RoshanAnand23/keyboard-PCB-design/Keyboard Overall Layout.jpg

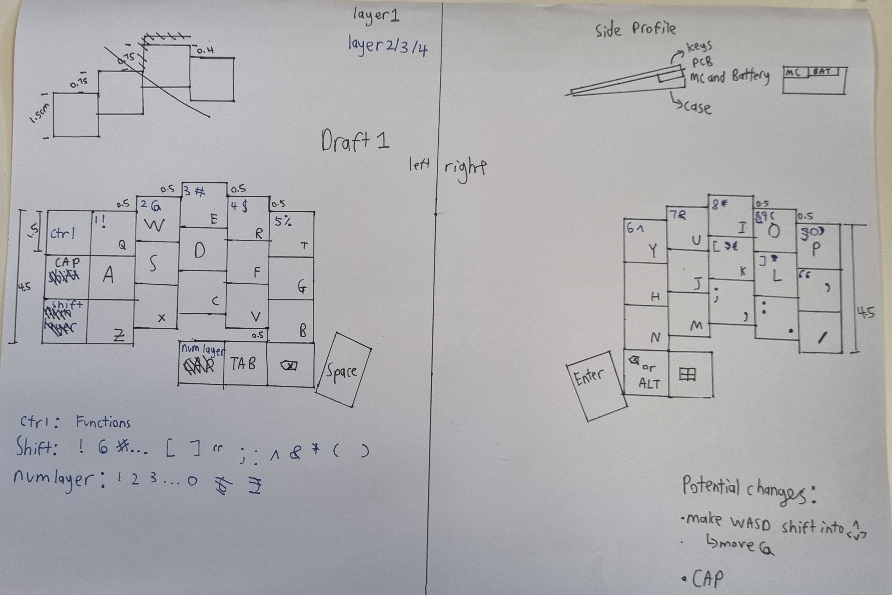
Keyboard Overall Layout.jpg
