RoshanAnand23/keyboard-PCB-design/README.md

# keyboard-PCB-design
learning to design a keyboard from pcb level
