RoshanAnand23/keyboard-PCB-design/Pinout comparison.docx

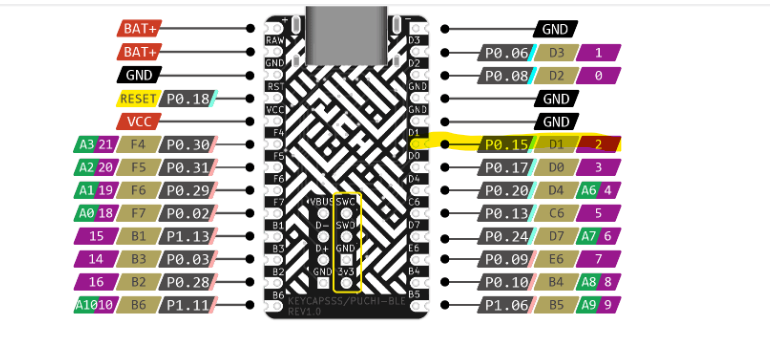
[picture p2: figure]
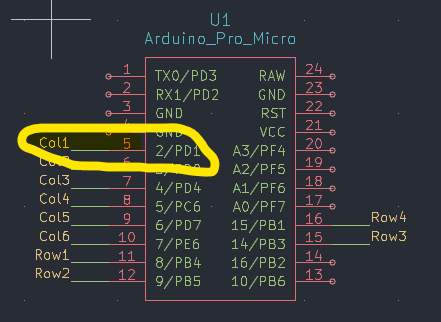
[picture p3: figure]

For future reference of how the schematic and physical pins correlate
