RoshanAnand23/keyboard-PCB-design/LeftKeyboard_kicad/Screenshots/LeftKeyboard-PCBLAYOUT.png

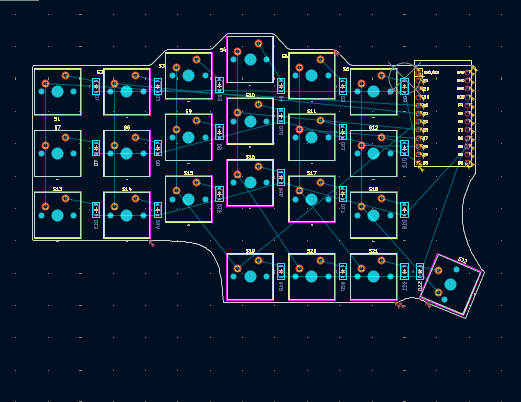
LeftKeyboard_kicad/Screenshots/LeftKeyboard-PCBLAYOUT.png
