RoshanAnand23/keyboard-PCB-design/LeftKeyboard_kicad/Screenshots/LeftKeyboardFinalPCB.png

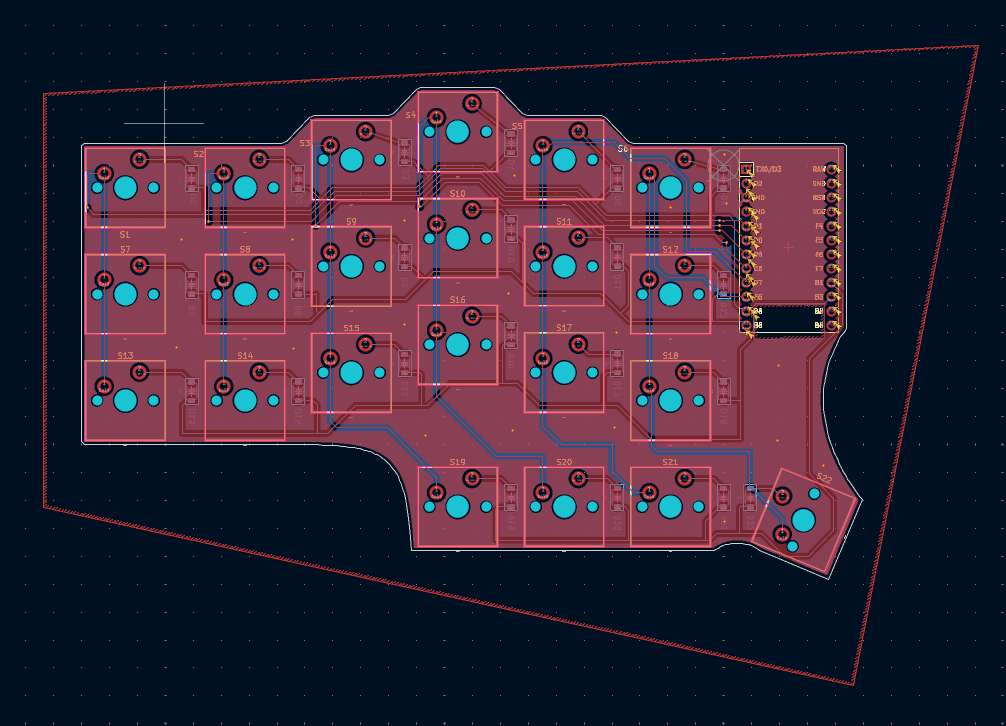
LeftKeyboard_kicad/Screenshots/LeftKeyboardFinalPCB.png
