RoshanAnand23/keyboard-PCB-design/LeftKeyboard_kicad/Screenshots/LeftKeyboardROUTING.png

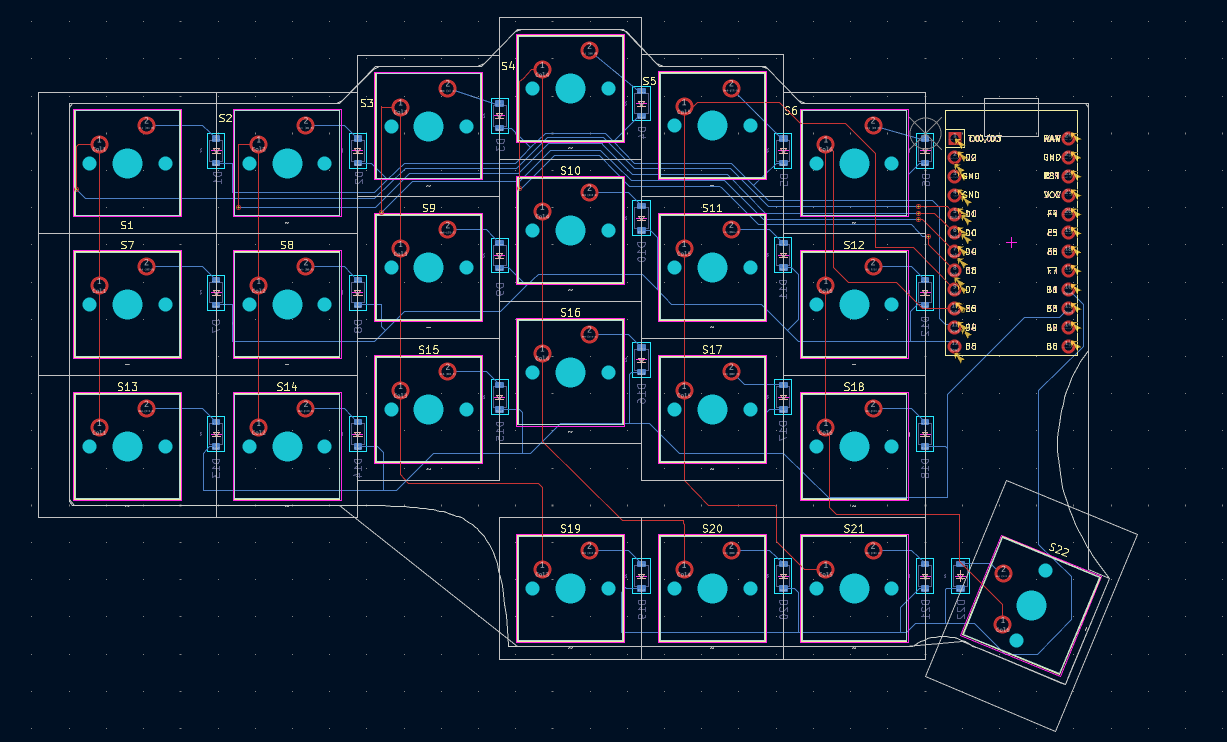
LeftKeyboard_kicad/Screenshots/LeftKeyboardROUTING.png
