RoshanAnand23/keyboard-PCB-design/LeftKeyboard_kicad/Screenshots/LeftKeyboardSchematicImag.png

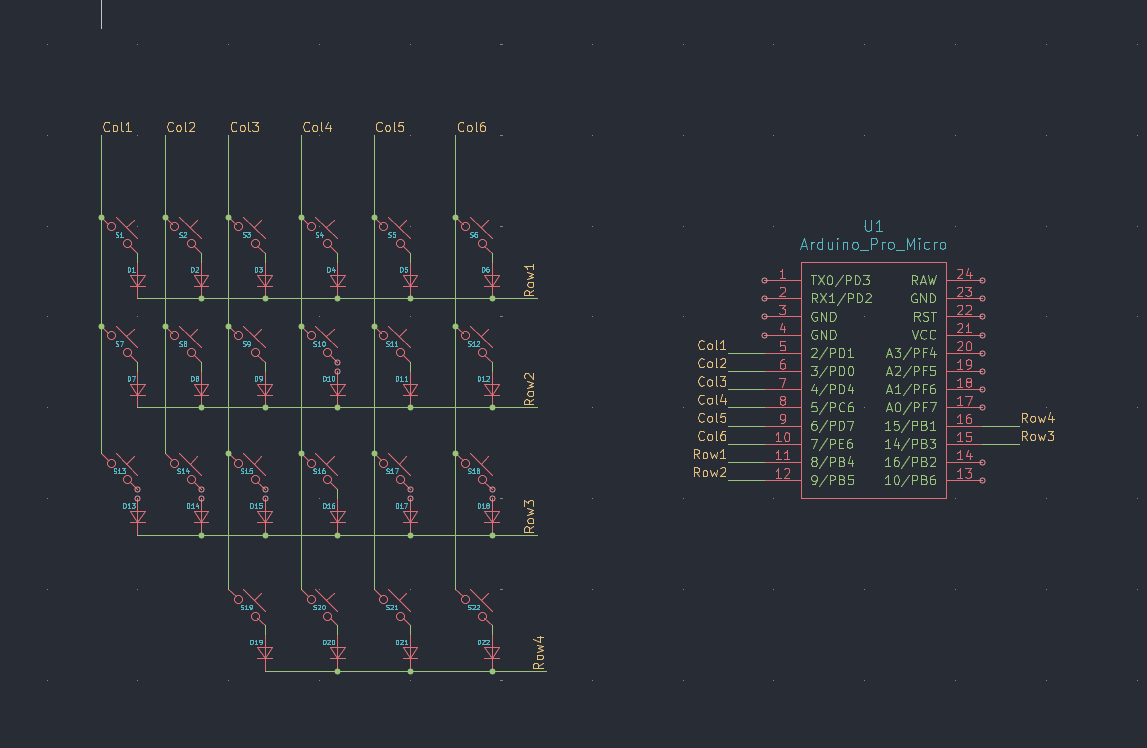
LeftKeyboard_kicad/Screenshots/LeftKeyboardSchematicImag.png
