RoshanAnand23/keyboard-PCB-design/RightKeyboard_kicad/RightKeyboardROUTING.png

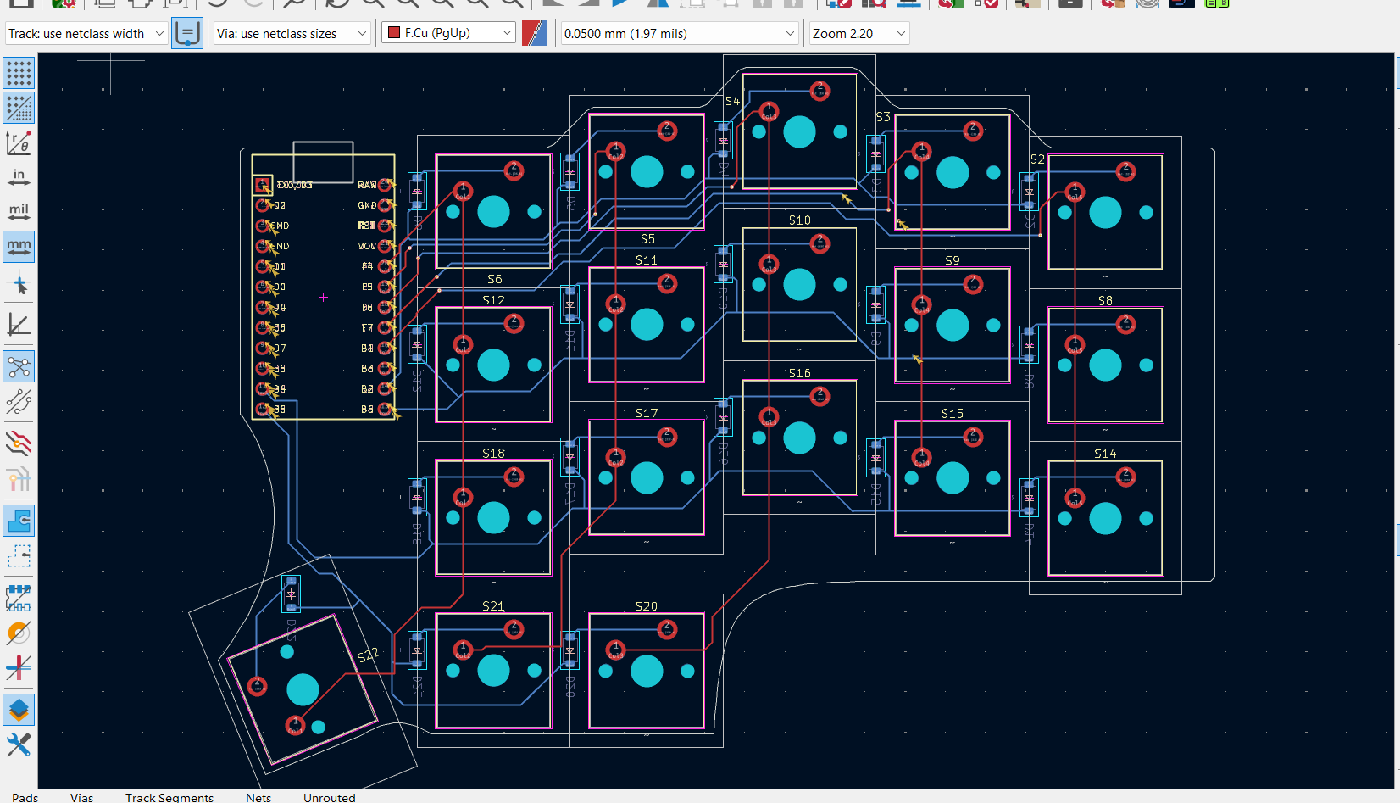
RightKeyboard_kicad/RightKeyboardROUTING.png
