RoshanAnand23/keyboard-PCB-design/RightKeyboard_kicad/Screenshot/RightKeyboardFinalPCB.png

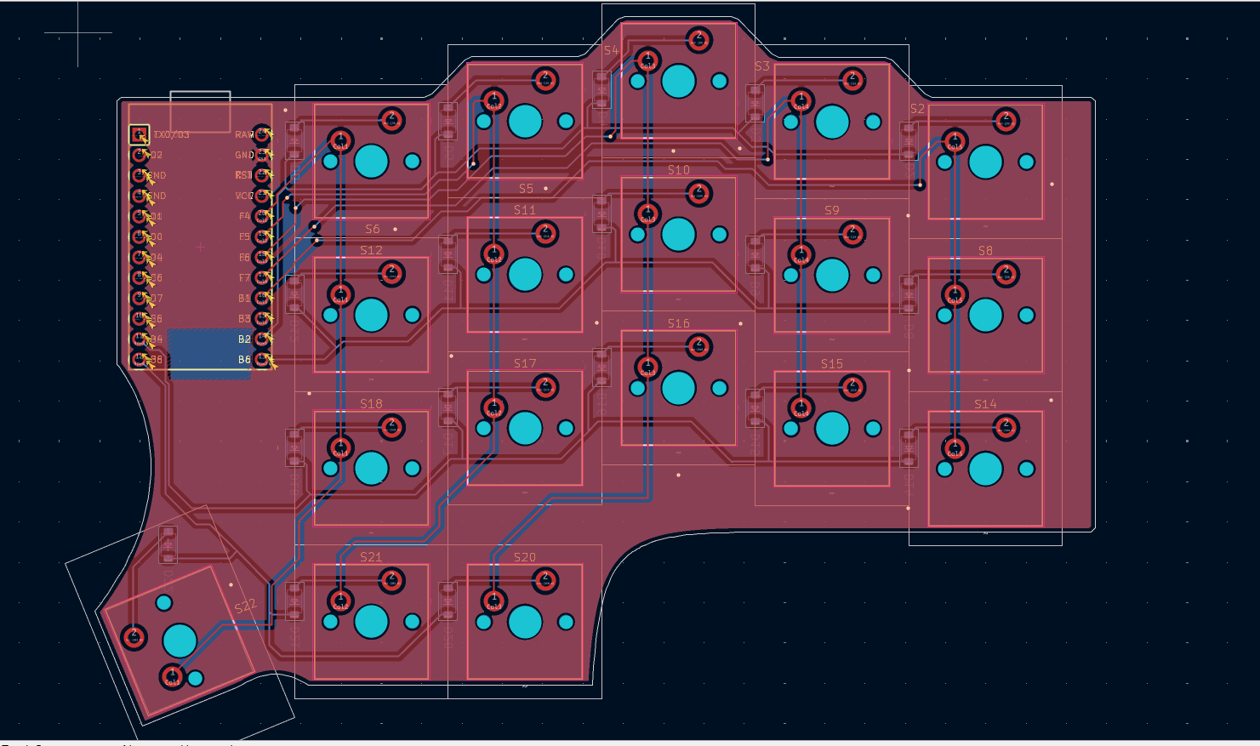
RightKeyboard_kicad/Screenshot/RightKeyboardFinalPCB.png
