RoshanAnand23/keyboard-PCB-design/RightKeyboard_kicad/RightKeyboard_kicad.kicad_pcb

## KiCad design RightKeyboard_kicad/RightKeyboard_kicad.kicad_pcb (2026-08-26)

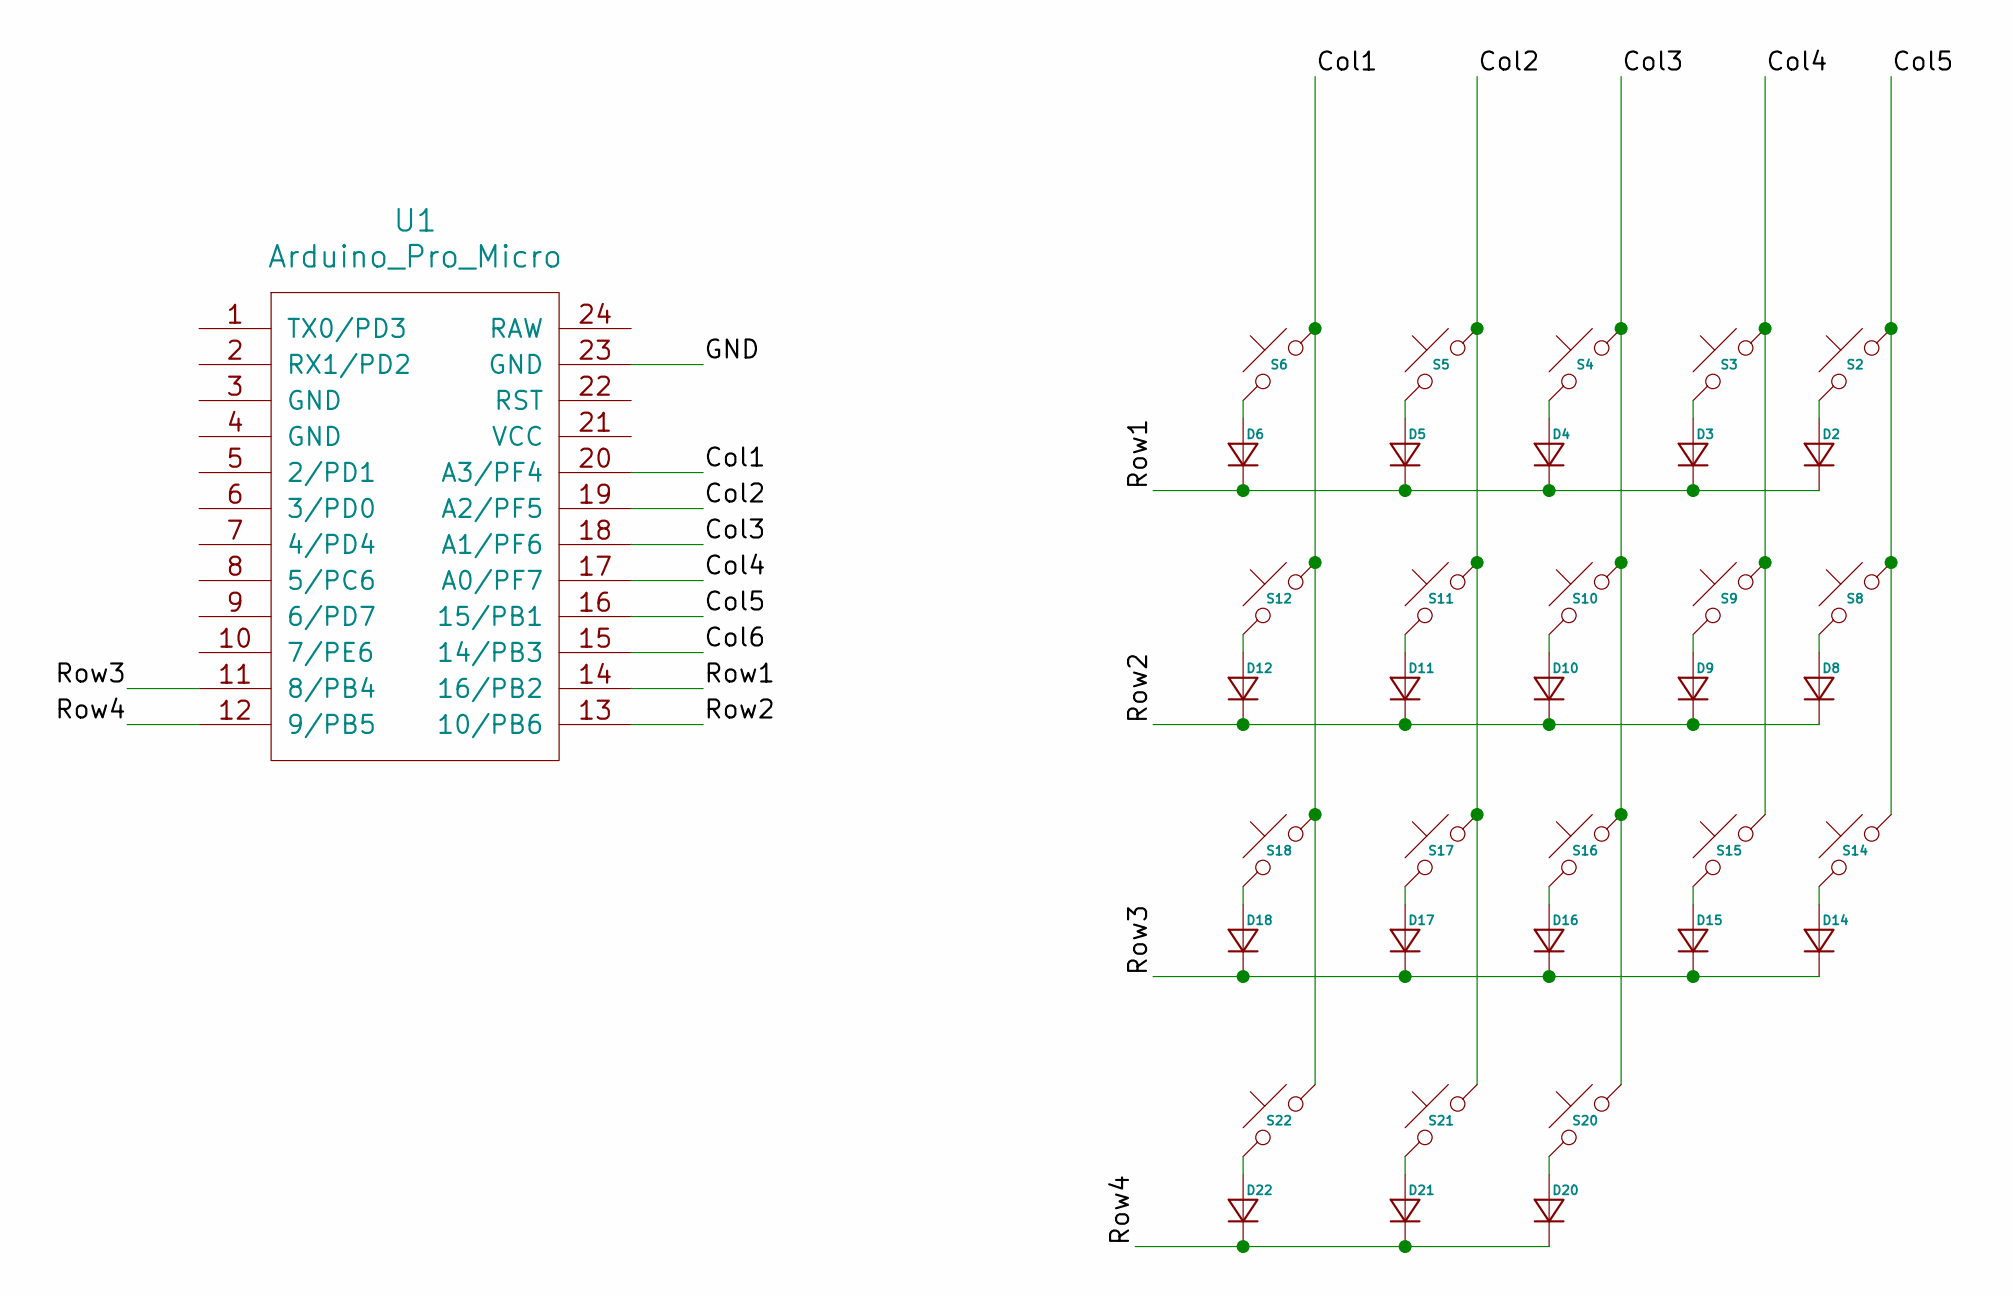
[picture p10: schematic RightKeyboard_kicad.kicad_sch]

Parts:
D2, D3, D4, D5, D6, D8, D9, D10, D11, D12, D14, D15, D16, D17, D18, D20, D21, D22: Diode_SOD-123
S2, S3, S4, S5, S6, S8, S9, S10, S11, S12, S14, S15, S16, S17, S18, S20, S21: MX_PCB_1.00u
S22: MX_PCB_1.50u
U1: Arduino_Pro_Micro

Connections:
/Col1: S6.1, S12.1, S18.1, S22.1, U1.20 (A3/PF4)
/Col2: S5.1, S11.1, S17.1, S21.1, U1.19 (A2/PF5)
/Col3: S4.1, S10.1, S16.1, S20.1, U1.18 (A1/PF6)
/Col4: S3.1, S9.1, S15.1, U1.17 (A0/PF7)
/Col5: S2.1, S8.1, S14.1, U1.16 (15/PB1)
/Col6: U1.15 (14/PB3)
/GND: U1.23 (GND)
/Row1: D2.1 (K), D3.1 (K), D4.1 (K), D5.1 (K), D6.1 (K), U1.14 (16/PB2)
/Row2: D8.1 (K), D9.1 (K), D10.1 (K), D11.1 (K), D12.1 (K), U1.13 (10/PB6)
/Row3: D14.1 (K), D15.1 (K), D16.1 (K), D17.1 (K), D18.1 (K), U1.11 (8/PB4)
/Row4: D20.1 (K), D21.1 (K), D22.1 (K), U1.12 (9/PB5)
unnamed: D2.2 (A), S2.2
unnamed: D3.2 (A), S3.2
unnamed: D4.2 (A), S4.2
unnamed: D5.2 (A), S5.2
unnamed: D6.2 (A), S6.2
unnamed: D8.2 (A), S8.2
unnamed: D9.2 (A), S9.2
unnamed: D10.2 (A), S10.2
unnamed: D11.2 (A), S11.2
unnamed: D12.2 (A), S12.2
unnamed: D14.2 (A), S14.2
unnamed: D15.2 (A), S15.2
unnamed: D16.2 (A), S16.2
unnamed: D17.2 (A), S17.2
unnamed: D18.2 (A), S18.2
unnamed: D20.2 (A), S20.2
unnamed: D21.2 (A), S21.2
unnamed: D22.2 (A), S22.2

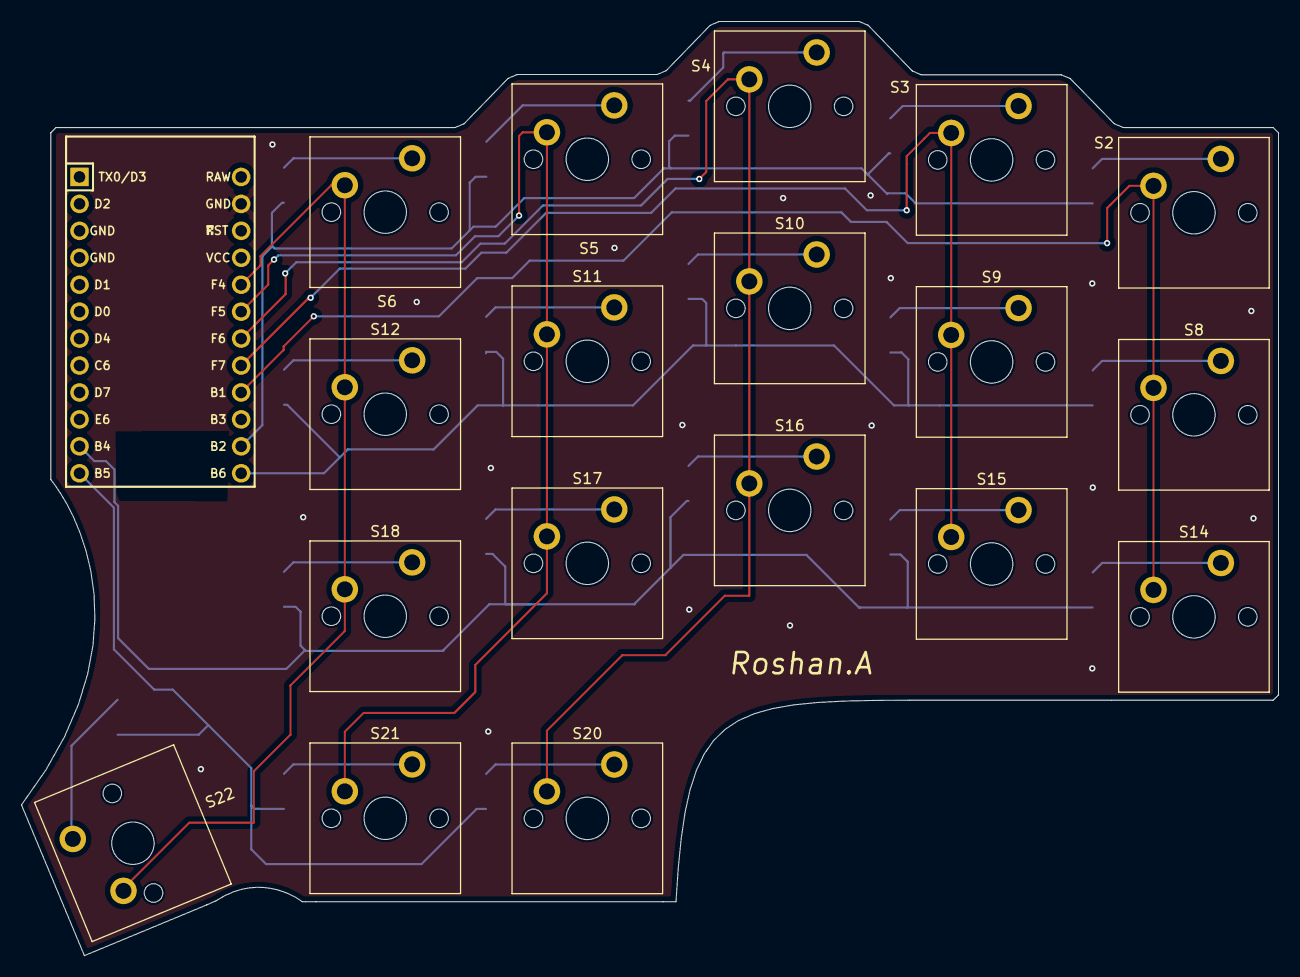
[picture p11: board RightKeyboard_kicad.kicad_pcb from above]

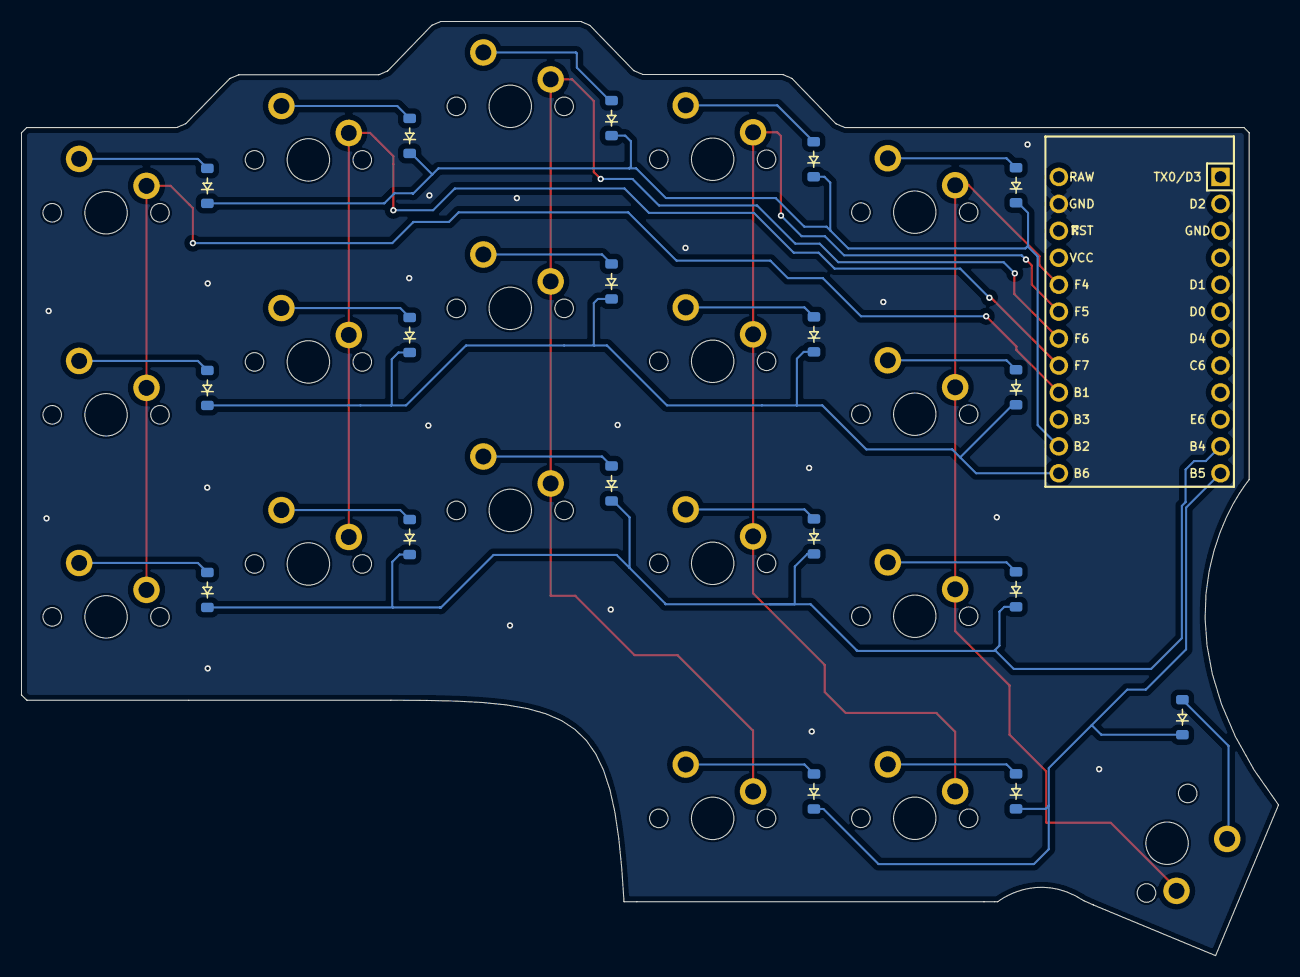
[picture p12: board RightKeyboard_kicad.kicad_pcb from below]

Board: 2 copper layers, 118.5 x 88.1 mm, 37 parts (18 on the bottom side), 27 nets.
