RoshanAnand23/keyboard-PCB-design/logbook.md

The purpose of this logbook is to write down my thought process, and reasons for my decisions. It is not an actual step by step process to make the keyboard.

keyboard layout design found in *Keyboard Overall Layout.jpg*

///////////////////////////////////////////////////////////////////////////////////

Starting with figuring out how the overall structure of a keyboard PCB layout is structured

(SUMMARY: schematic have whole circuit with footprints, then in PCB design, arrange them)

**Plugins** used with Kicad(to consider):

**HTML BOM**: list of materials

**place footprints:** makes moving components(that has footprints assigned) easier(even spacing)

**round tracks**:smooth already routed tracks(purely aesthetic, idk if will use)

**Simple Libraries:** many components(symbol+footprint) included

\*\*KiCad library for Arduino modules:\*\*makes it easy to include Arduino mc(dont even need to assign footprints)

**JLC:** fabrication toolkit???(haven't added) So that, after finish design, files formatted to directly order PCB

**Understanding Keyboard Matrix and Direct Wiring**

Direct Wiring: grid of switches, each switch has a dedicated controller pin

**Matrix**(with diode):each column and row has a dedicated controller pin

A column connects to one side of the switch pin, while  each row is connected to a diode connected to the other switch pin

Controller sends a pulse into the matrix and listens on the other end of the matrix. Depending on its voltage level, it correspond to a specific switch being detected

//////////////////////////////////////////////////////////////////////////////

**Starting the Design:**(Do more research before starting)

* Getting a library that includes the mechanical switches schematics and footprints

(https://github.com/joe-scotto/scottokeebs/tree/main/Extras/ScottoKicad)

(https://github.com/kiswitch/kiswitch/tree/main)should be included in the above

* In schematic: set up switch+diode, and generate the matrix
* wire up(row and column)
* place controller and connect row/columns to pins on controller
* assign pcb footprints to schematic(hopefully library has footprints)
* In PCB: Update PCB(bring components to PCB designer)
* Set grid according to components spacing, and set origin point

TIP:3D viewer to see where physically placed, can place within the white space accordingly

TIP: Consider which layer to place everything

* Route everything, and run outline
* Run DRC
* Fieldzone
* Extract for fabrication(JLC)

TIPS: surface finish, HASL(basic and affordable), ENIG(expensive).

**FIRMWARE:**

Considering using either using QMK firmware(https://qmk.fm/), or ZMK firmware(https://zmk.dev/docs/features/split-keyboards).

QMK is for wired connection, better if i were to make a single wired keyboard,

ZMK is ideal for wireless split keyboard

Keymap code: https://nickcoutsos.github.io/keymap-editor/

**From my understanding**, QMK would be the easier to set up, it is done in c(i have experience), and the process seems much more straightforward.

However, I have decided to use ZMK, namely for the wireless feature since that would be more practical for daily use.

**What i must consider considering i am using ZMK:**

* Understand GitHub actions(on a basic level)
* Include batteries(and potentially a BMS) into the circuit design: Based on the boards/lipo battery i am planning to use, it should be fine.
* consider a new layout that involves split screen.
* *FOR FUTURE: Dongle option to improve battery capability(sounds link ZMK makes the upgrade process really easy*

**Components:**

I need to consider components that are compatible with ZMK, and ideally able to handle a battery module(https://zmk.dev/docs/hardware)

**Puchi-BLE V1**(https://keycapsss.com/keyboard-parts/mcu-controller/202/puchi-ble-wireless-microcontroller-pro-micro-replacement)

Has an on/off switch, Li-Po battery charger (4.2V Lithium @ 100mAh)

*Only use LiPo batteries with a protection circuit, because the Puchi-BLE has no low voltes (discharge) protection for batterie*s

*NOTE: It is the orange tape(with some electronics) at the top of the battery*

30 euros^^ would most likely get the component quicker

**NOTE: An Arduino Pro Micro replacement, so can use the same footprint**

**nice!nano**(https://kriscables.com/product/nicenano/?utm\_source=nicekeyboards\&utm\_medium=referral\&utm\_campaign=find-a-store)

Would probably be the easiest to set up, similar to above.

30 euros

Reminder: Before you solder or plug any battery into one of these wireless boards, ALWAYS check that the red wire is going to B+ and the black wire is going to B- / GND

**Keycap:**

Site for keycaps etsy: (https://www.etsy.com/listing/1441551215/xda-blank-keycap-custom-keycap-custom?ls=a\&ga\_order=most\_relevant\&ga\_search\_type=all\&ga\_view\_type=gallery\&ga\_search\_query=low+profile+apple+keycaps\&ref=sc\_gallery-1-7\&sr\_prefetch=1\&pf\_from=market\&pro=1\&sts=1\&plkey=Eu2sJL2uWpj7TboUaT-fakflYq70%3ALT6e985c341e1baf15e20121c1e7fb9c842215bf55\&variation0=6185040888)

(https://www.amazon.co.uk/FOLODA-Keycaps-Personality-Supplement-Computer-Gray/dp/B0CKQPH9QP/ref=sr\_1\_21?crid=1LK2SXJO84A7P\&dib=eyJ2IjoiMSJ9.9TcicRQ-rgKeEsNZG88xXLxir6P\_1TdJPyPi\_bPpOVRlI9VsAPUJmKdEcnApjwK0sD14xHNgxxC1w7OOTFtR-0KD0CZ6Br9V\_P6C4kYQKPHnoDjwTCLJcRE41oqWaBqqAuXJw0kvHorDIuKu3gco69qyufa7iXuEmeriqBgeEXlXVDhp0hKiE6JO0AjRF8FeOxP802vEY7YdbfzsHmPSV5kNHRNltvJghV5p7aRRMa4.g8c0JSJD08KC\_qEKMFl7d42ffLOe74vAW9He-7DhH7I\&dib\_tag=se\&keywords=XDA%2Bprofile%2C%2BDSA%2Bprofile%2C%2Bor%2BMOA%2Bprofile%2Bblank%2Bkeycap\&qid=1787031320\&sprefix=xda%2Bprofile%2Bdsa%2Bprofile%2Bor%2Bmoa%2Bprofile%2Bblank%2Bkeycap%2Caps%2C336\&sr=8-21\&th=1)

XDA profile, DSA profile, or MOA profile

Key Switch:

MX style: Haimu Whisper Silent Tactile Switch

(https://cannonkeys.com/products/haimu-whisper-silent-tactile-switch?srsltid=AfmBOoqKRaLQne966JjXv\_auseRBswyh\_EF\_Zi8NprU\_BSAoJcHOmYEl)

Alternatively: https://prototypist.net/search?q=Haimu+Whisper+Silent+Tactile+Switch

Has many more options, in smaller packs, easy to find Cherry MX Equivalent

////////////////////////////////////////////////////////////////////////////

**STARTING**

Now starting it on kicad(i will make the layout later)

Basic steps

* Get the library on kicad and start it(schematic)  (DONE)
* work on layout                                    (DONE)
* **Make left side(and duplicate project and rearrage for right side**
* Make 3D Printed case
* fabricate and order components(mc, switches, caps)
* solder
* flash
* hopefully it works

##### GETTING LIBRARY ON KICAD-left

I used DownGit to download the specific folder from (https://github.com/joe-scotto/scottokeebs/tree/main/Extras/ScottoKicad), and then added them to my leftKeyboard and rightKeyboard project folders. These were the libraries where the symbol/footprints were from)

Then I added the libraries to the project specific library

How to get there:(main menu, preferences, manage symbol/footprint libraries, project specific library)

NOTE: Do not need to create/modify the path.

NOTE: Schematic are mainly for the MC, the switches would just use the normal switch schematic, and only the footprint would be what is needed from the library

**(HAVENT DONE THIS STEP FOR THE RIGHT KEYBOARD)^^**

### LEFT SIDE(KEYBOARD)

##### SCHEMATIC-left

I started placing the switch, diode and Controller schematics(for left Keyboard)

The pinout for the controller(https://help.keycapsss.com/build-guides/puchi-ble/)

I was slightly confused by the pinout:

I believe Pin1(which is on the top left of the schematic, corresponds to the top right of the pinout microcontroller which shouldn't actually impact the schematic too much, as long as i am careful during the PCB step)

Explanation shown in *Pinout comparison.docx)*

I decided that i will solder the battery directly to the MC post fabrication, but it is worth noting that the pinout shows the Bat+ and Bat- to be to the sides of the usb port(top)

NOTE OF PIN connections in schematic vs corresponding pinout:

Col1-pin5 D1

Col2-pin6 D0

Col3-pin7 D4

Col4-pin8 C6

Col5-pin9 D7

Col6-pin10 E6

Row1-pin11 B4

Row2-pin12 B5

Row3-pin15 B1

Row4-pin16 B3

**After understanding the pins, and know what to keep track of during the PCB stage, the schematic of the left keyboard is done.**

* Potentially add a reset button for the reset pin?

##### FOOTPRINTS-Left

Assigning footprints to the components

With the library that i had already added to project, I should just need to add apply the footprints.

Considering the components i am using, the switches should follow the Cherry MX style, or something equivalent. the diodes should be the ~~od35s~~ SOD123 diode(footprint included in library)

I had an issue where i couldn't see the libraries' footprint. I later discovered that i need to add the folders with the .pretty into the list, not the entire parent footprint folder

For the diode I assigned the D035 diode(from the scottokeebs library

NOTE: To quickly find components, select library on the left side, before searching

for key switch, 1u, 2u all determines what type of key it is,

**I will be using: 1u is the normal ones,**

**I will use 1.25u for (CTRL(s1), CAP(s7),SHIFT(s13)**

**I will use 1.5u for the space(s22) and enter**

NOTE: 1u up to 1.17u all use the same keyswitch, only differentiating key cap size. Any larger ones would need stabilizers

Controller already had its footprint assigned

##### PCB

###### Switch Grid

Arranging the switches: i decided to use a custom grid(ctrl shift m to measure)

each key switch(including key cap placeholder) is 19mm(19.05mm)

So i will be setting a custom grid of(19.05mm/8)

NOTE: a standard keycap is around 18mm, so the outline provided by footprint(from library) already takes it into account, so outline should touch without overlap/space.

Had an issue where the footprints were aligning to different grids.

I attempt to solve this using a smaller grid, 19.05/64

Semi-Giving up, i deleted all the components, and updated PCB again. I suspect that since the components are brought in aligned, setting my custom grid should work this time.

^^didn't work

**SOLUTION**: I need to set grid origin on the top left corner of one of the switches, then for every other switch, 'move with reference' on the same point on its footprint(top left corner)

(right click- positioning tools- move with reference- click point on footprint)

In the end, i used custom grid (19.05mm/8)

For the space bar i rotated it at an angle of 67.5(midpoint between 90deg and 45deg)

then used move by reference to move its corner by one grid unit down from s21's bottom right corner

###### Diode placement

Did the same thing for the diodes, where i set the grid origin as the midpoint between the switches

**NOTE:I have decided to switch the footprint of the diode to sod123, As this diode can come presoldered when ordering on JLC, and have through holes, which may interfere with the switches.**

##### Final layout

I grouped the columns so that i could easily shift them to match the keyboard layout in (keyboard overall layout.jpg)

i made the grid 0.5mm and moved in increments until the height offsets were about 0.5cm.

**Edge Cut(the pcb layer)**

Using the User.Drawings line, i traced the edge of the component. Using a custom grid(space from component edge to pcb edge), i moved the line 1 grid unit away, and i then rounded the edges.

(https://www.allpcb.com/allelectrohub/mastering-component-spacing-a-practical-guide-to-dfa-guidelines)<--The ideal distance from component to the edge cut of a keyboard PCB)

The keyswitch footprint already includes an outline for the keycap. From what i have seen, it says 3mm is ideal distance from component to pcb edge. The keyswitch footprint is 2.5 mm away from its keycap placeholder line. So could i will the distance from keycap placeholder space to edge of pcb 0.5mm.

HOWEVER, since the PCB edge does not Need to be beyond the keycap placeholder edge, and that 3mm consideration is meant for automated pcb manufacturing, it may be reasonable to set the distance to be **1mm** from edge of keyswitch footprint(ignoring keycap placeholder), to pcb edge.

For the controller, i need to add a hole in the pcb where the port/switch will go. I made a hole(with a 1mm buffer between edge and controller through holes)

(LATER CHANGES IT TO NOT NEED THIS STEP, AS PIN HEADERS SOLVES THIS

I also moved the silk screen labels to not overlap any footprints

The Scottokeebs library has the 3d files of the components for the 3D viewer. The view them, in PCB layout, press 'e', configured path

To improve the aesthetic, i Used Bezier Curve, fillet lines and chamfer lines to smoothen the edges.

Additionally, i just had to make sure none of the pcb edges intersects with the silkscreen lines.

NOTE: With Bezier curves, the Gerber file approximates hundreds of straight line, so an Arc would be safer, but i will attempt with Bezier curve first(just minimize usage)

Used chamfer of 0.5mm for most corners, and Beziel curve, but kept it reasonably smooth.

##### WIRING

Starting to route the components. Will consider increasing pcb size if not enough space.

CHECK ON DIODE D7 silkscreen

NOTE: From the appearance tab(on right side), can toggle show only front/back to make routing easier

For the rows, i connect switch to top of diode, then made a shared bus(starting from initial diode), then connected that to switch, while connecting other diodes in that row to the shared bus.

For the collumns, i connect the switches vertically, but it makes routing the top switch to controller difficult(as they are blocked by those vertical routes), so i used vias and routed them horizontally on the back layer

(Leaving a 0.5mm between the vias)

**NOTE: When routing, start with one layer wire, (PRESS V) then continue to the other layer wire automatically**

**(PRESS D) to fix routes**

**(PRESS F) to auto finish routes**

Vias, kept the default kicad config, as this would minimize the cost.

Keeping distance >0.3mm between routes

##### FILLED ZONES

**TODO:FILLED ZONES**

NOTE: When adding a filled zone, i should avoid the antenna in the MC, which is the part at the very edge of the controller(on the other side across the port for this specific controller)- *USING A DRAW RULE AREA*

B.Cu, Add filled zone, select NET(GND), draw zone, PRESS B to fill zones, Run DRC

The benefit of adding a filled zone, even though there is no GND/POWER lines(since controller only sends data to and from the switches), is to prevent warping

The ground plane also helps with isolation(preventing noise)

I plan to have the GND plane on **both the top and bottom layers.**

To have a Ground Plane, to include it, i need to **add a GND net in the schematic**

Additionally, add vias for improved heat distribution.

Summary: Draw Rule Area for antenna, filled zone GND net both layers, Vias to fill in missed zones, additional vias for heat dissipation.

Planning to do about 1 vias for every 4 switches, with a couple extra in empty spaces.

#### DRC

Shows no erros, but showed warning related to (Silkscreen clipped by board edge) and (silkscreen clipped by solder mask).

Since these are not issues, i can solve by just cleaning up the silkcreen lines, leaving it as is, as apparently manufacturers like JLC would automatically clip/resolve these kind of issues.

#### CHANGES

I have decided to include the entire Controller within the PCB layout, as following what the 3D viewer shows, i can just use a Pin Header, so prevent the need of cutting out part of the pcb

* ***This is fine as long as the Controller orientation is for the back layer***

### RIGHT SIDE(KEYBOARD)

I am going to try copying(either files or direct ctrl c and v, into a new project to save time on repeating the above steps

Firstly, i add the scottokeebs library to the project specific library(schematic and footprints) in the right keyboard project.

Then i copied and pasted the schematic.

I rearranged the rows and colums for right keyboard layout(there is one less column)

I changed the footprints to match the new layout

**I will be using: 1u is the normal ones,**

**I will use 1.5u for the space(s22) and enter**

Now i can either rearrange the controller pins config work better for the right side(more of the pins will face the switches), OR i could keep the same pin config.

I plan to change the pin config("While looking at the *pin comparison.png,* and consider datasheet

NOTE OF PIN connections in schematic vs corresponding pinout:

Col1-pin20 F4

Col2-pin19 F5

Col3-pin18 F6

Col4-pin17 F7

Col5-pin16 B1

Col6-pin15 B3

Row1-pin14 B2

Row2-pin13 B6

Row3-pin11 B4

Row4-pin12 B5

I then (In PCB layout), copied the left keyboard pcb layout and pasted it into the rightkeyboard layout.

I then global delete(in edit), to remove all the routing and vias.

I then grouped the edge cut and flipped it

I rearranged the switches(CHECKed IF ORDER MATCHES SCHEMATIC)

I then opened the left keyboard pcb layout and will try to mirror the arangement as best as i can(Using measuring tools ctrl shift m)

Moved the diodes to the left of the switches

Now i shortened the edge cut's end because the right keyboard has one less column

Noticed an issue where the routing matched the previous project(left keyboard), rather then the current project's schematic.

Solution: When i go to update PCB, select the update footprint option

Routed(and via) the components similar to the left keyboard, 

I then added a GND filled zone to both layers, and placed thermal vias around.

(Also added a draw rule area around antenna)

### EXTRA

Ive finished the PCB layout for both keyboards, my next step would be to, export files to order from JLC, design the 3D printed casing, get firmware ready to flash.

HOWEVER, i would like to add art to the silkscreen

FOR NOW I JUST ADDED MY NAME, BUT ADDING A SYMBOL OR SMT WOULD BE NICE
