RoshanAnand23/keyboard-PCB-design/(commit log)

2026-08-16 Starting point
    [PCB Design.kicad_pcb, PCB Design.kicad_sch]
2026-08-18 finalised plan
    [keyboard-project-kicad.kicad_pcb, keyboard-project-kicad.kicad_sch]
2026-08-19 Added libraries to left Keyboard, and started the schematic
    [LeftKeyboard_kicad.kicad_pcb, LeftKeyboard_kicad.kicad_sch, RightKeyboard_kicad.kicad_pcb, RightKeyboard_kicad.kicad_sch]
2026-08-19 Completed schematic for left keyboard
    [LeftKeyboard_kicad.kicad_sch]
2026-08-20 made considerable progress on pcb layout
    [LeftKeyboard_kicad.kicad_pcb, LeftKeyboard_kicad.kicad_sch]
2026-08-24 Routed the keyboard
    [LeftKeyboard_kicad.kicad_pcb]
2026-08-25 finish Left PCB, starting right
    [LeftKeyboard_kicad.kicad_pcb, LeftKeyboard_kicad.kicad_sch]
2026-08-25 Started right keyboard, schematic and pcb layout
    [RightKeyboard_kicad.kicad_pcb, RightKeyboard_kicad.kicad_sch]
2026-08-26 Finished Right Keyboard PCB
    [LeftKeyboard_kicad.kicad_pcb, RightKeyboard_kicad.kicad_pcb]
